jmmarino2/whammy/README.md

# whammy
WHAMMY headphone amplifier, as showed in diyAudio.com
