jmmarino2/whammy/schematics/whammy_kicad/power_square_pcb_components.pdf

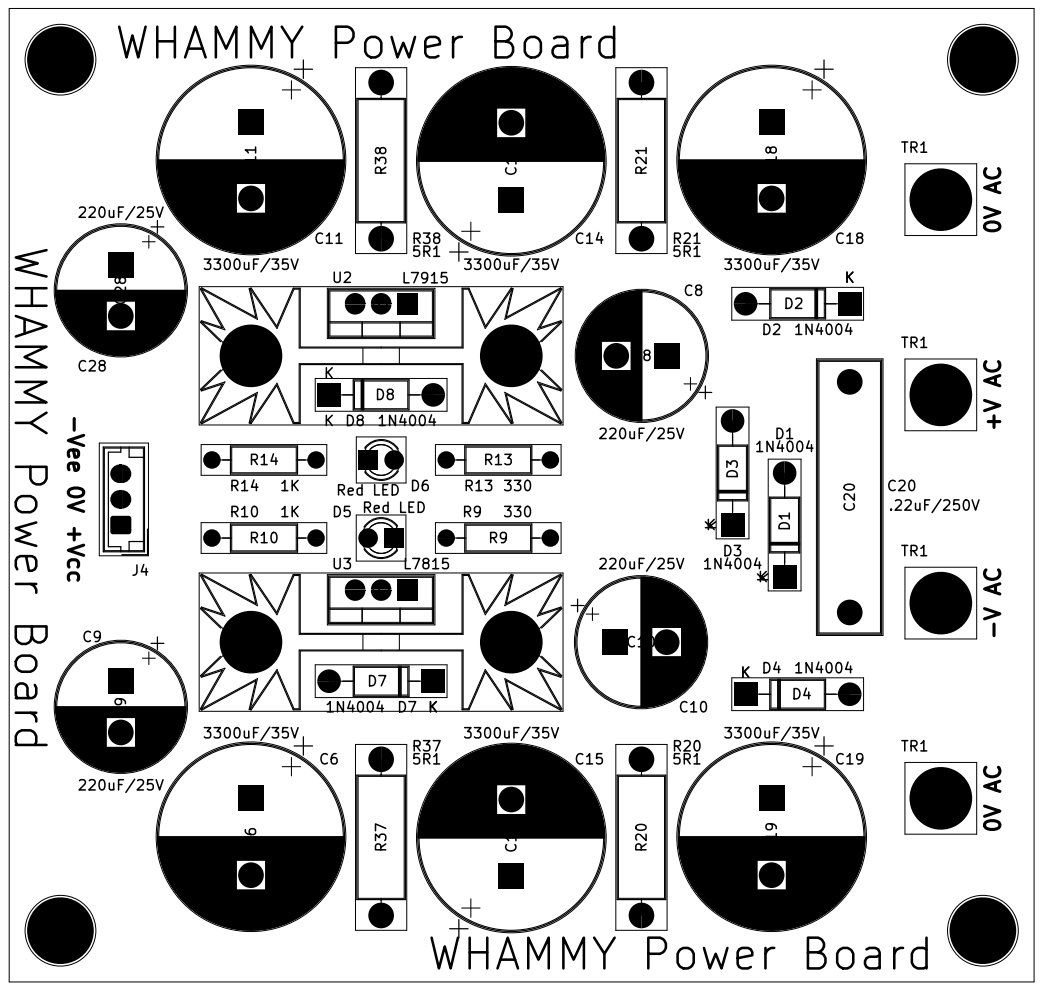
[picture p1: page 1]
