jmmarino2/whammy/schematics/whammy_kicad/whammy_pcb_components.pdf

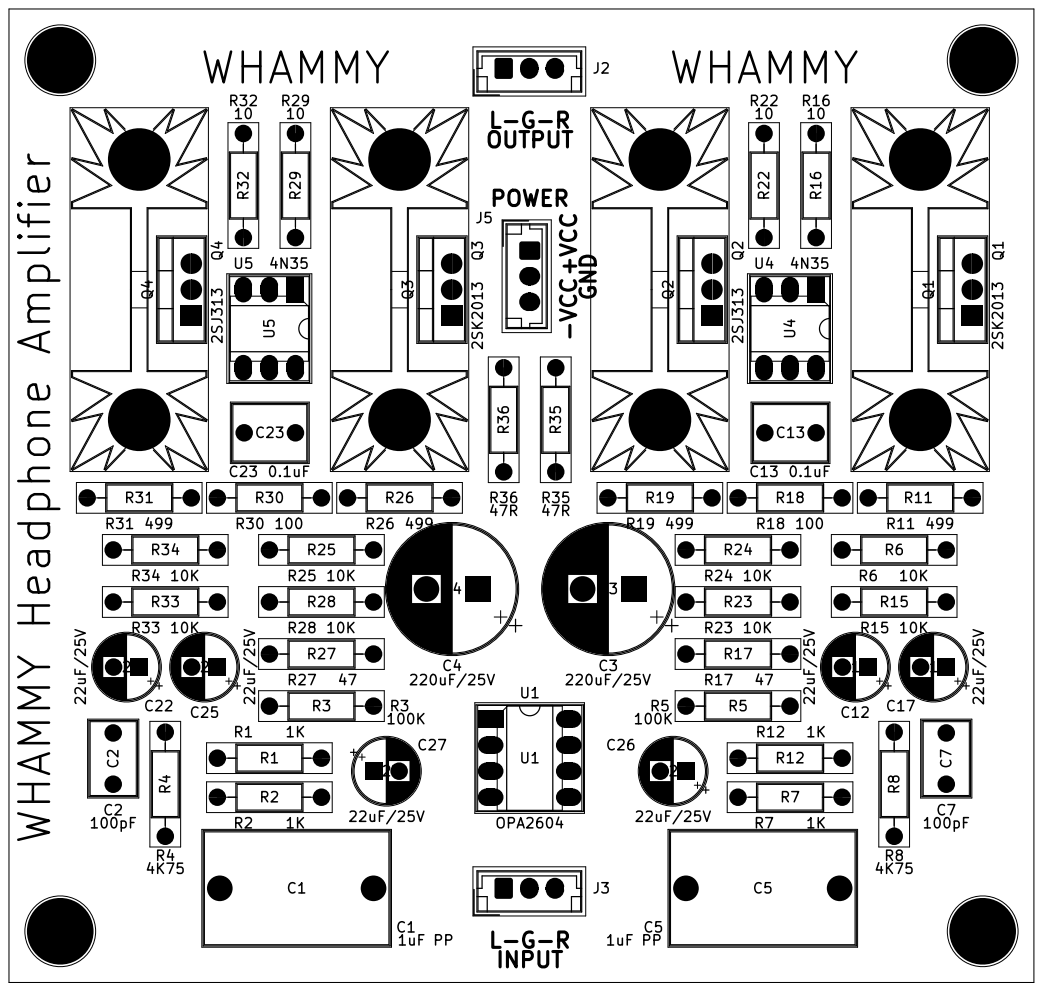
[picture p2: page 1]
