jmmarino2/whammy/schematics/whammy_kicad/whammy.kicad_pcb

## KiCad design schematics/whammy_kicad/whammy.kicad_pcb (2021-11-10)

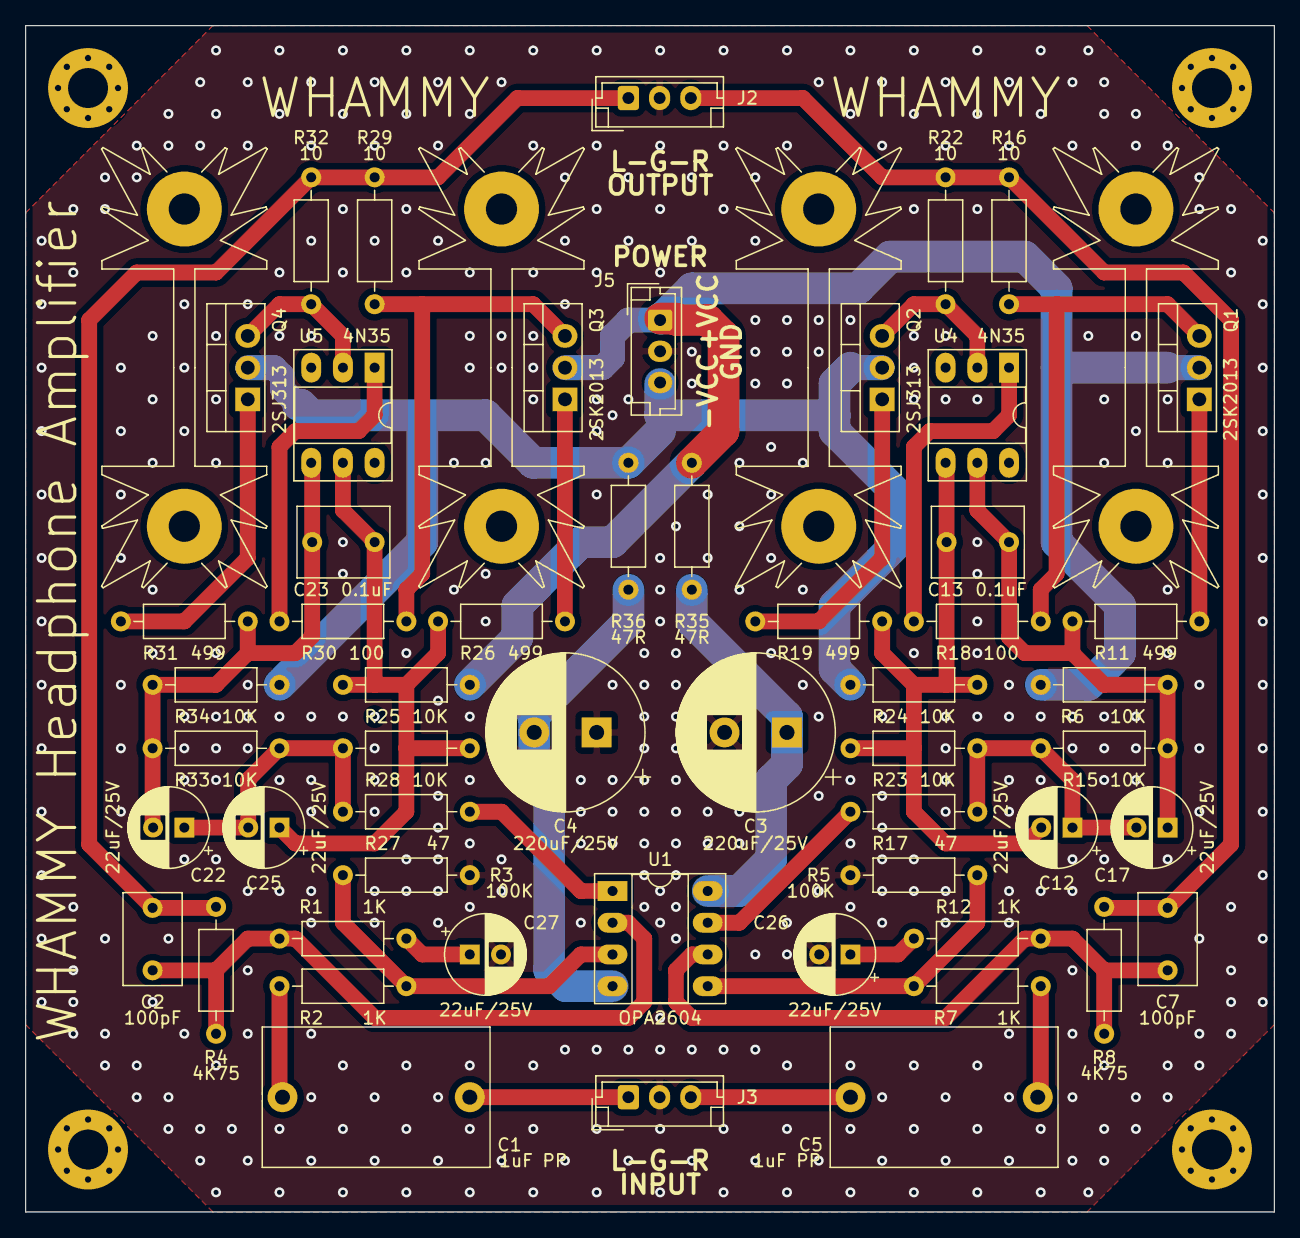
[picture p3: board whammy.kicad_pcb from above]

Board: 2 copper layers, 100.0 x 95.0 mm, 54 parts (0 on the bottom side), 35 nets.

Parts:
C1, C5: 1uF PP; C_Rect_L18.0mm_W11.0mm_P15.00mm_FKS3_FKP3
C2, C7: 100pF; C_Rect_L7.2mm_W4.5mm_P5.00mm_FKS2_FKP2_MKS2_MKP2
C3, C4: 220uF/25V; CP_Radial_D12.5mm_P5.00mm
C12, C17, C22, C25, C26, C27: 22uF/25V; CP_Radial_D6.3mm_P2.50mm
C13, C23: 0.1uF; C_Rect_L7.2mm_W5.5mm_P5.00mm_FKS2_FKP2_MKS2_MKP2
J2, J3, J5: Conn_01x03; JST_EH_B3B-EH-A_1x03_P2.50mm_Vertical
Q1, Q3: 2SK2013; TO-220-3_Vertical
Q2, Q4: 2SJ313; TO-220-3_Vertical
R1, R2, R7, R12: 1K; R_Axial_DIN0207_L6.3mm_D2.5mm_P10.16mm_Horizontal
R3, R5: 100K; R_Axial_DIN0207_L6.3mm_D2.5mm_P10.16mm_Horizontal
R4, R8: 4K75; R_Axial_DIN0207_L6.3mm_D2.5mm_P10.16mm_Horizontal
R6, R15, R23, R24, R25, R28, R33, R34: 10K; R_Axial_DIN0207_L6.3mm_D2.5mm_P10.16mm_Horizontal
R11, R19, R26, R31: 499; R_Axial_DIN0207_L6.3mm_D2.5mm_P10.16mm_Horizontal
R16, R22, R29, R32: 10; R_Axial_DIN0207_L6.3mm_D2.5mm_P10.16mm_Horizontal
R17, R27: 47; R_Axial_DIN0207_L6.3mm_D2.5mm_P10.16mm_Horizontal
R18, R30: 100; R_Axial_DIN0207_L6.3mm_D2.5mm_P10.16mm_Horizontal
R35, R36: 47R; R_Axial_DIN0207_L6.3mm_D2.5mm_P10.16mm_Horizontal
U1: OPA2604; DIP-8_W7.62mm_Socket_LongPads
U4, U5: 4N35; DIP-6_W7.62mm_Socket_LongPads

Connections:
+15V: J5.1, Q1.2, Q3.2, R6.1, R25.1, R35.1
-15V: J5.3, Q2.2, Q4.2, R24.2, R34.2, R36.2
GND: C3.2, C4.1, C26.2, C27.2, J2.2, J3.2, J5.2, R3.2, R5.2
LEFT_OUT: C7.2, J2.3, R8.2, R16.2, R22.1
unnamed: C1.1, J3.1
unnamed: C1.2, R2.2
unnamed: C2.1, R1.1, R4.1, U1.2
unnamed: C3.1, R35.2, U1.8
unnamed: C4.2, R36.1, U1.4
unnamed: C5.1, J3.3
unnamed: C5.2, R7.2
unnamed: C7.1, R8.1, R12.1, U1.6
unnamed: C12.1, C17.2, R15.2, R17.2, R23.1
unnamed: C12.2, C13.2, R19.1, R23.2, R24.1, U4.4
unnamed: C13.1, C17.1, R6.2, R11.1, R15.1, U4.5
unnamed: C22.1, C25.2, R27.2, R28.2, R33.1
unnamed: C22.2, C23.2, R31.1, R33.2, R34.1, U5.4
unnamed: C23.1, C25.1, R25.2, R26.1, R28.1, U5.5
unnamed: C26.1, R12.2
unnamed: C27.1, R1.2
unnamed: Q1.1, R11.2
unnamed: Q1.3, R16.1, R18.1
unnamed: Q2.1, R19.2
unnamed: Q2.3, R22.2, U4.2
unnamed: Q3.1, R26.2
unnamed: Q3.3, R29.1, R30.1
unnamed: Q4.1, R31.2
unnamed: Q4.3, R32.2, U5.2
unnamed: R2.1, R3.1, U1.3
unnamed: R5.1, R7.1, U1.5
unnamed: R17.1, U1.7
unnamed: R18.2, U4.1
unnamed: R27.1, U1.1
unnamed: R30.2, U5.1
RIGHT_OUT: C2.2, J2.1, R4.2, R29.2, R32.1
