jmmarino2/whammy/schematics/whammy_kicad/power_long.kicad_pcb

## KiCad design schematics/whammy_kicad/power_long.kicad_pcb (2021-11-10)

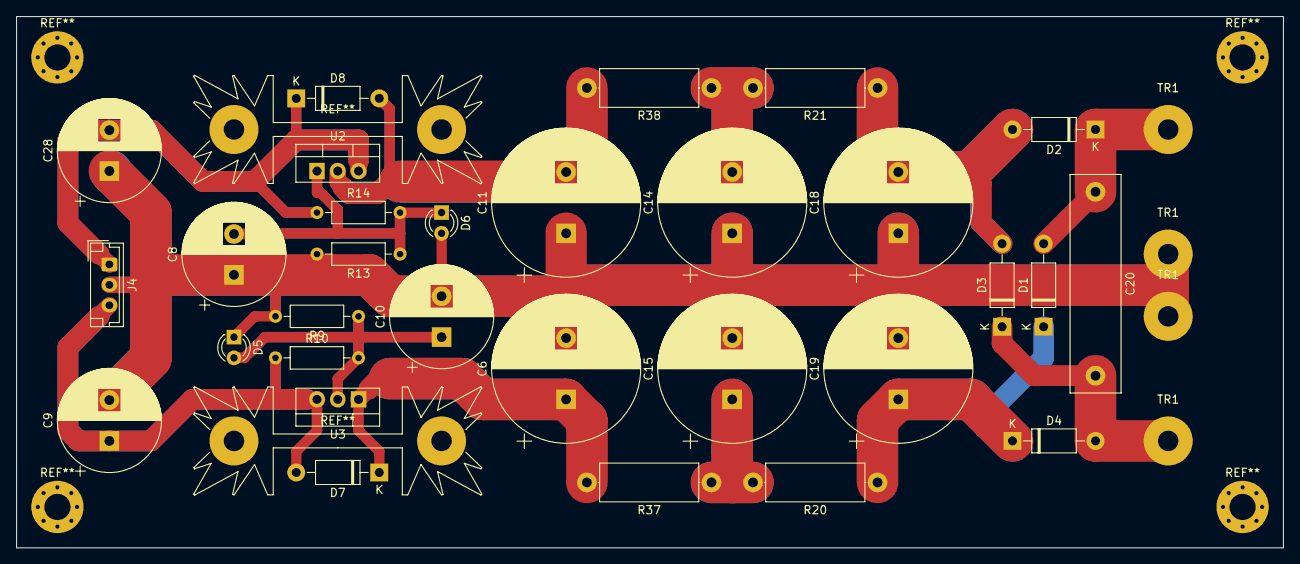
[picture p4: board power_long.kicad_pcb from above]

Board: 2 copper layers, 155.0 x 65.0 mm, 34 parts (0 on the bottom side), 13 nets.

Parts:
C6, C11, C14, C15, C18, C19: 3300uF/35V; CP_Radial_D18.0mm_P7.50mm
C8, C9, C10, C28: 220uF/50V; CP_Radial_D12.5mm_P5.00mm
C20: .22uF/250V; C_Rect_L26.5mm_W6.0mm_P22.50mm_MKS4
D1, D2, D3, D4, D7, D8: 1N4004; D_DO-41_SOD81_P10.16mm_Horizontal
D5, D6: Red LED; LED_D3.0mm
J4: Conn_01x03; JST_EH_B3B-EH-A_1x03_P2.50mm_Vertical
R9, R13: 330; R_Axial_DIN0207_L6.3mm_D2.5mm_P10.16mm_Horizontal
R10, R14: 1K; R_Axial_DIN0207_L6.3mm_D2.5mm_P10.16mm_Horizontal
R20, R21, R37, R38: 5R1; R_Axial_DIN0414_L11.9mm_D4.5mm_P15.24mm_Horizontal
TR1, TR1#2, TR1#3, TR1#4: SolderWirePad_1x01_Drill2.5mm
U2: L7915; TO-220-3_Vertical
U3: L7815; TO-220-3_Vertical

Connections:
+15V: C9.1, D7.2, J4.3, R10.1, U3.3
-15V: C28.2, D8.1, J4.1, R14.1, U2.3
GND: C6.2, C8.1, C9.2, C10.2, C11.1, C14.1, C15.2, C18.1, C19.2, C28.1, D5.1, D6.2, J4.2, R9.2, R13.2, TR1.5, TR1#2.6
unnamed: C6.1, D7.1, R37.2, U3.1
unnamed: C8.2, D6.1, R13.1, R14.2, U2.1
unnamed: C10.1, D5.2, R9.1, R10.2, U3.2
unnamed: C11.2, D8.2, R38.2, U2.2
unnamed: C14.2, R21.2, R38.1
unnamed: C15.1, R20.2, R37.1
unnamed: C18.2, D2.2, D3.2, R21.1
unnamed: C19.1, D1.1, D4.1, R20.1
unnamed: C20.1, D1.2, D2.1, TR1#4.4
unnamed: C20.2, D3.1, D4.2, TR1#3.7
