jmmarino2/whammy/(commit log)

2021-09-25 First schematics
    [whammy.kicad_pcb, whammy.sch]
2021-09-26 Add footprints.
    [whammy.kicad_pcb, whammy.sch]
2021-09-29 PCB changes
    [power.kicad_pcb, whammy_one_heatsink.kicad_pcb]
2021-10-09 First PCB version with single heatsinks.
    [whammy.kicad_pcb, whammy.sch]
2021-11-10 Final version
    [power_long.kicad_pcb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]
